ArtemHerashchenko/coursework/README.md

# COURSEWORK
Coursework on the electronic component base of electronic equipment
