ArtemHerashchenko/coursework/Bill of Materials/[No Variations].xlsx

# | Description | Footprint | LibRef | Category | Manufacturer 1 | Manufacturer Part Number | Supplier 1 | Designator | Case/Package | Stock 1 | Quantity | Pricing 1 | Unit price
1 | Quad 2-input Positive-NAND Gates 14-PDIP 0 to 70 | DIP794W45P254L1969H508Q14 | SN7400N | Logic - Gates and Inverters | Texas Instruments | SN7400N | Digi-Key | U | 14-DIP | 934 | 1 | 1=1,64000, 10=1,46900, 25=1,38600, 100=1,18080, 250=1,10876, 500=0,97016, 1000=0,87341 (USD) | $1.64000
2 | RES SMD 150 OHM 5% 1/5W 0402 | RESC1005X40N | RCS0402150RJNED | Chip Resistor - Surface Mount | Vishay Dale | RCS0402150RJNED | Digi-Key | R4 | 0402 (1005 Metric) | 6385 | 1 | 1=0,12000, 10=0,10500, 100=0,04020, 1000=0,01771, 2500=0,01530, 5000=0,01368 (USD) | $0.12000
3 | 2.5 x 6.5 mm, 2.5 A, Horizontal, Through Hole, Dc Power Jack Connector | CUI_PJ-037B | PJ-037B | Barrel - Power Connectors | CUI | PJ-037B | Digi-Key | J | Bag | 10016 | 1 | 1=0,59000, 10=0,55100, 25=0,49640, 50=0,44120, 100=0,42280, 250=0,38604, 500=0,36764, 1000=0,30330, 2500=0,27573 (USD) | $0.59000
4 | Ceramic Multilayer Capacitor; Capacitor Type:General Purpose; Capacitance:0.068ÂµF; Capacitance Tolerance:Â± 5%; Voltage Rating:10VDC; Capacitor Dielectric Type:Multilayer Ceramic; Package/Case:0805; Termination Type:SMD ;RoHS Compliant: Yes | CAPC2012X135N | LMK212SD683JG-T | Capacitors | Taiyo Yuden | LMK212SD683JG-T | Digi-Key | C1 | 0805 (2012 Metric) | 10627 | 1 | 1=0,51000, 10=0,35600, 50=0,24960, 100=0,21390, 500=0,16042, 1000=0,13547 (USD) | $0.51000
5 | DIODE ZENER 5.1V 200MW 1005 | Zener_5.1V | CZRF52C5V1 | Zener Diodes | Comchip | CZRF52C5V1 | Digi-Key | ZD1 | 1005 | 10482 | 1 | 1=0,48000, 10=0,35400, 100=0,20060, 500=0,13282, 1000=0,10183, 2000=0,08855 (USD) | $0.48000
6 | Res Thick Film 0402 750 Ohm 5% 1/16W Â±200ppm/Â°C Molded SMD SMD Paper Tape on Plastic Reel | RESC1005X40N | CR0402-JW-751GLF | Chip Resistor - Surface Mount | Bourns | CR0402-JW-751GLF | Digi-Key | R3 | 0402 (1005 Metric) | 20000 | 1 | 1=0,10000, 10=0,02000, 100=0,00810, 1000=0,00366, 2500=0,00318, 5000=0,00262 (USD) | $0.10000
7 | CAP CER 100PF 10V C0G/NP0 0805 | RESC1005X40N | CR0402-JW-302GLF | Chip Resistor - Surface Mount | Bourns | CR0402-JW-302GLF | Digi-Key | R1 | 0402 (1005 Metric) | 15113 | 1 | 1=0,10000, 10=0,01300, 100=0,00540, 1000=0,00244, 2500=0,00212, 5000=0,00175 (USD) | $0.10000
8 | 9.7 mm, Omnidirectional, PCB Mount, 3.0 Vdc, Electret Condenser Microphone | MIC_CMA-4544PF-W | CMA-4544PF-W | Audio Products Microphones | CUI Devices | CMA-4544PF-W | Digi-Key | MK | Box | 40117 | 1 | 1=0,77000, 10=0,65800, 25=0,61520, 50=0,58340, 100=0,55250, 500=0,48388, 1000=0,45580, 5000=0,39428 (USD) | $0.77000
9 | a braid of a small conductor for an antenna | Antenna | Antenna | antennas | - | - | - | A1 | - | - | 1
10 | 100pF Â±5% 10V Ceramic Capacitor C0G, NP0 0402 (1005 Metric) | WCAP-CSGP_885012005013 | 885012005013 | Capacitors | Wurth Electronics | 885012007004 | Digi-Key | C2 | 0805 (2012 Metric) | 5137 | 1 | 1=0,10000, 10=0,04600, 100=0,04150, 500=0,03674 (USD) | $0.10000
11 | 4.7 kOhms 0.5W, 1/2W PC Pins Through Hole Trimmer Potentiometer Cermet 25 Turn Top Adjustment | TRIM_3296W-1-472LF | 3296W-1-472LF | Trimmer Potentiometers | Bourns | 3296W-1-472LF | Digi-Key | R2 | Tube | 872 | 1 | 1=3,00000, 10=2,63900, 25=2,36600, 50=2,27500, 100=2,18400, 250=2,09300, 500=1,72900, 1000=1,63800, 5000=1,36500 (USD) | $3.00000
 |  |  |  |  |  |  |  |  |  |  | Product price (USD) | 7.41
 |  |  |  |  |  |  |  |  |  |  | Product price (UAH) | 207.48
