ArtemHerashchenko/coursework/3D/LMK212SD683JGT.step

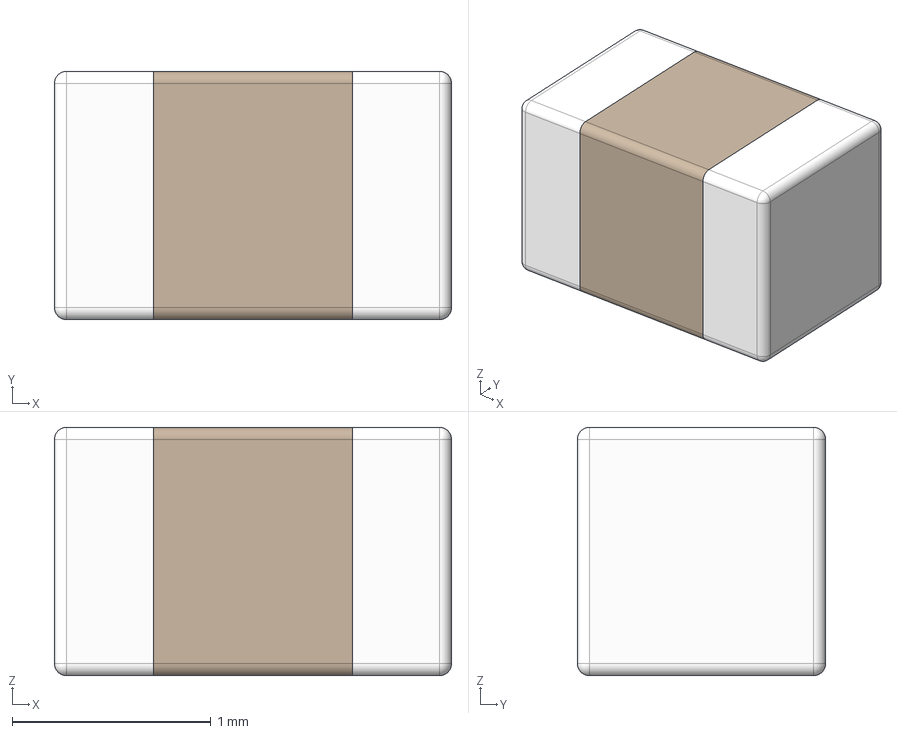
[picture p29: CAD file, 2021-06-01]
3D/LMK212SD683JGT.step
2.00 x 1.25 x 1.25 mm
