ArtemHerashchenko/coursework/3D/Zener_5.1V.step

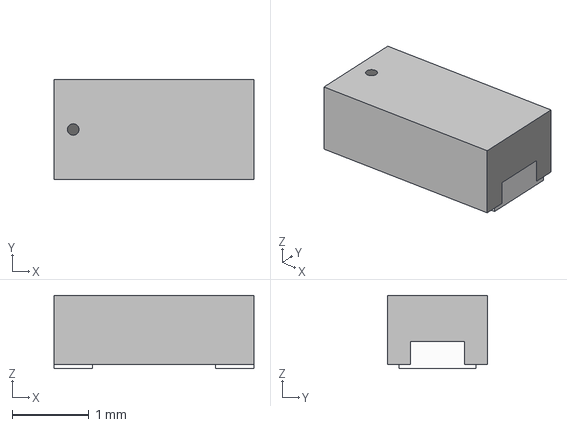
[picture p30: CAD file, 2021-06-01]
3D/Zener_5.1V.step
2.60 x 1.30 x 0.95 mm
