ArtemHerashchenko/coursework/Electrical circuit diagram/[No Variations].PDF

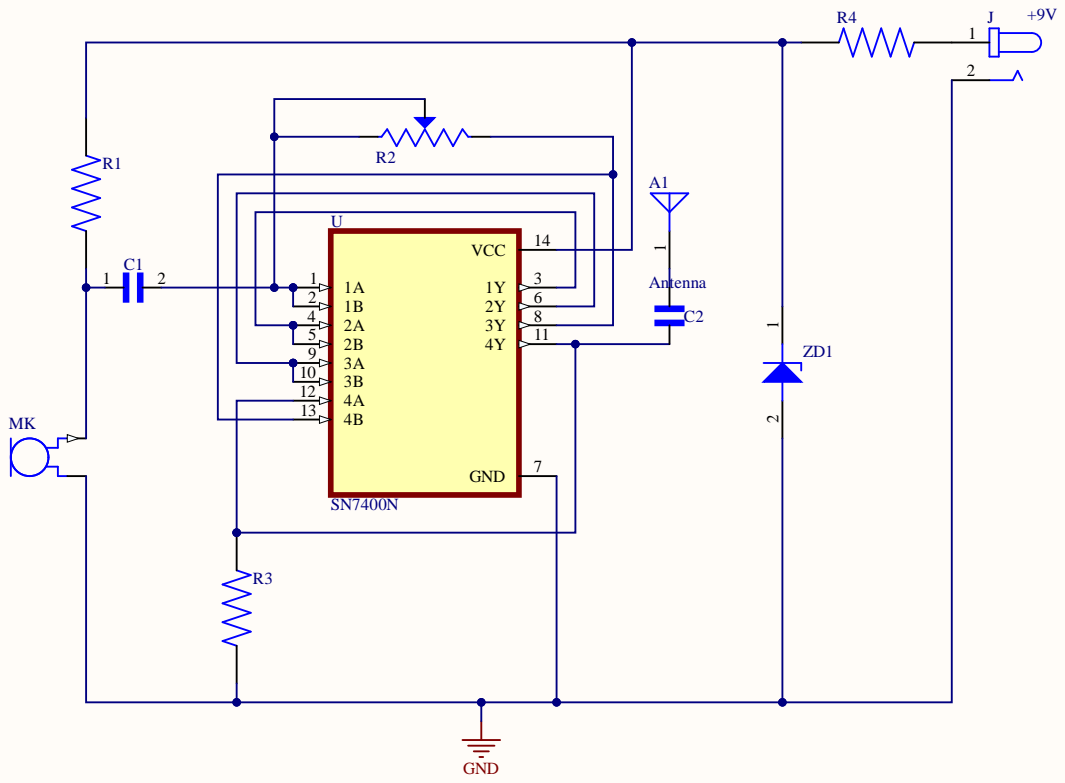
[picture p31: page 1]

A | 2 | Y Y
4 | 2 B 3 A 3 B 4 A 4 B | | 8
5 | 4 Y | 1 1
