ArtemHerashchenko/coursework/LTspice simulation files/FM_microphone.asc

C1: cap; 68n
C2: cap; 100p
D3: zener; 1N751
R1: res; 3k
R2: res; 4.7k
R3: res; 750
R4: res; 150
U1: 74hc00; VCC=5.1  SPEED=1.0  TRIPDT=1e-9
U2: 74hc00; VCC=5.1  SPEED=1.0  TRIPDT=1e-9
U3: 74hc00; VCC=5.1  SPEED=1.0  TRIPDT=1e-9
U4: 74hc00; VCC=5.1  SPEED=1.0  TRIPDT=1e-9
V1: voltage; 9
V2: voltage; wavefile=sound.wav
V3: voltage; SINE(0 0 50k)
Named nets: 0
.tran 1m
.inc 74HC.lib
